Tinkerforge/red-brick/README.rst

RED Brick
=========

This repository contains hardware design files and the build system for the
software image of the RED Brick. More information about it can be found
`here <http://www.tinkerforge.com/en/doc/Hardware/Bricks/RED_Brick.html>`__.
