Tinkerforge/red-brick/image/patches/root-fs/common/usr/share/images/tf-screensaver/tf-image.png

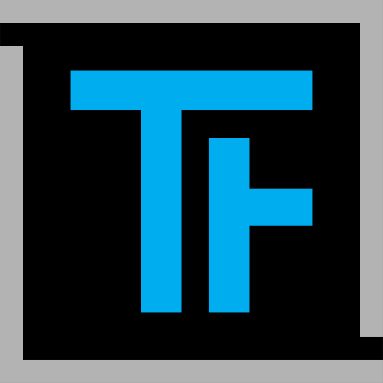
image/patches/root-fs/common/usr/share/images/tf-screensaver/tf-image.png
