Tinkerforge/red-brick/image/patches/root-fs/full/tmp/panel-buttons/tinkerforge-system-reboot.png

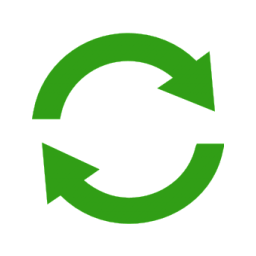
image/patches/root-fs/full/tmp/panel-buttons/tinkerforge-system-reboot.png
