Tinkerforge/red-brick/image/patches/root-fs/full/tmp/panel-buttons/tinkerforge-system-shutdown.png

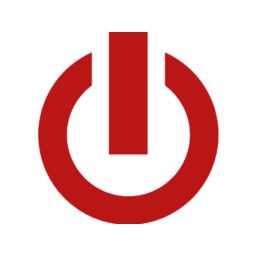
image/patches/root-fs/full/tmp/panel-buttons/tinkerforge-system-shutdown.png
