Tinkerforge/red-brick/software/examples/labview/Example Kill Program Process.vi.png

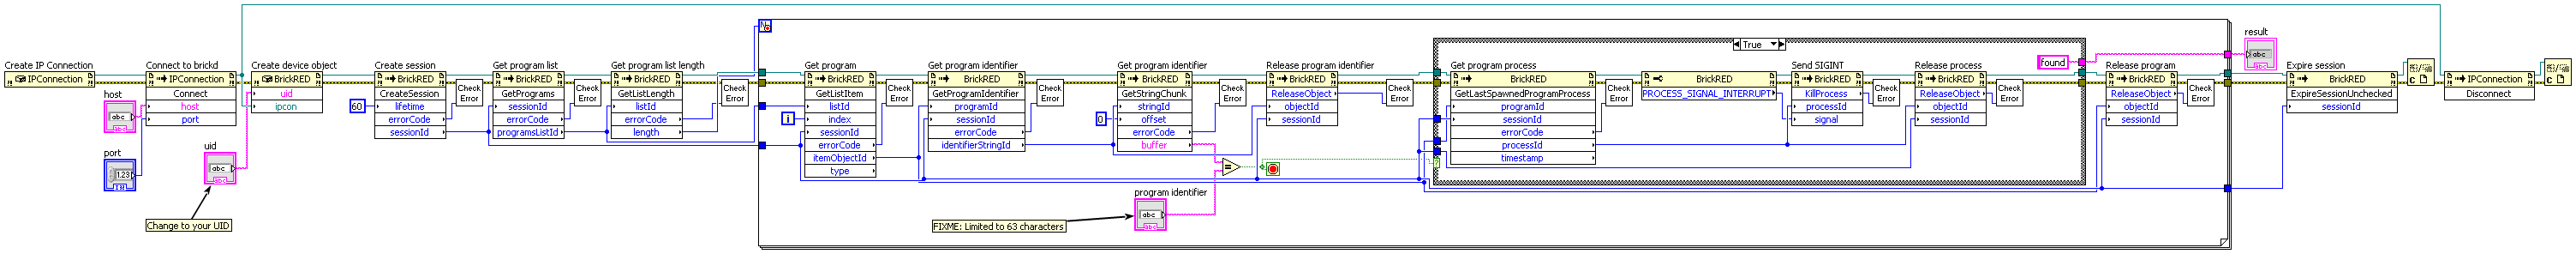
software/examples/labview/Example Kill Program Process.vi.png
