Tinkerforge/red-brick/software/examples/labview/Example Read File.vi.png

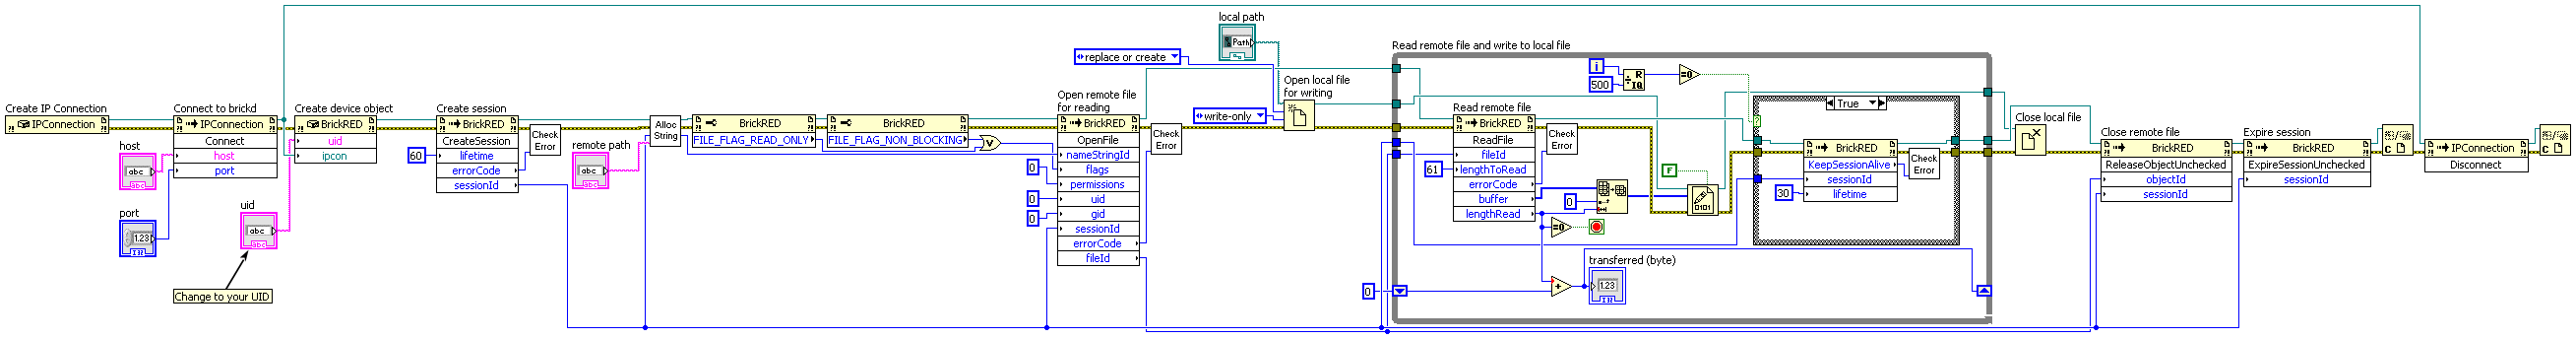
software/examples/labview/Example Read File.vi.png
