Tinkerforge/red-brick/software/examples/labview/Example Start Program.vi.png

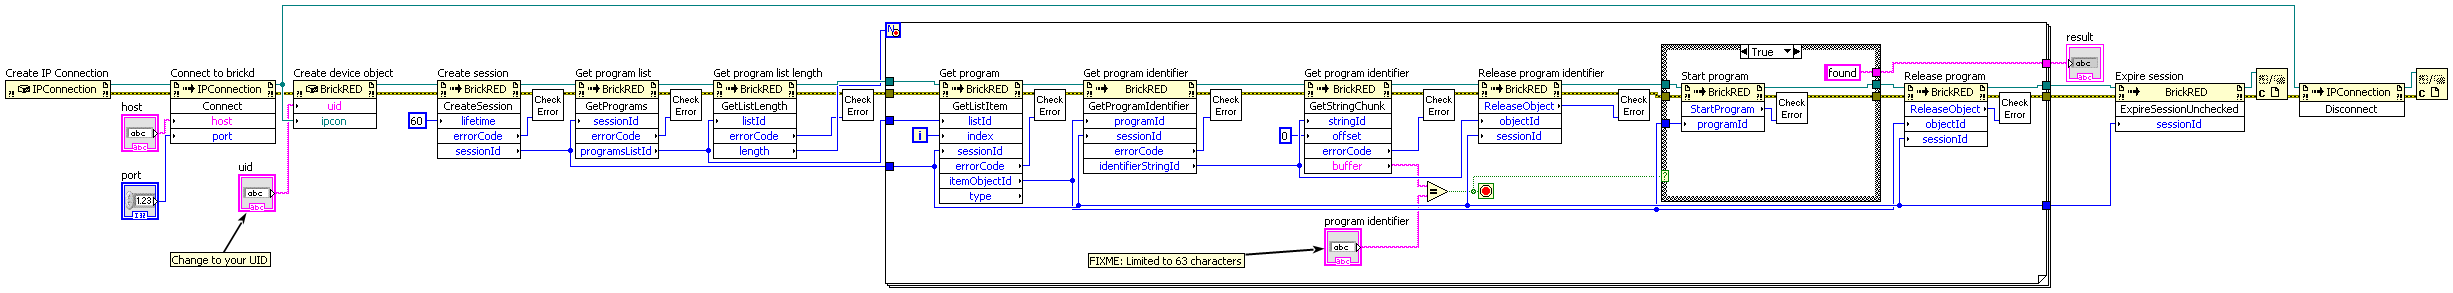
software/examples/labview/Example Start Program.vi.png
