Tinkerforge/red-brick/software/examples/labview/Example Write File.vi.png

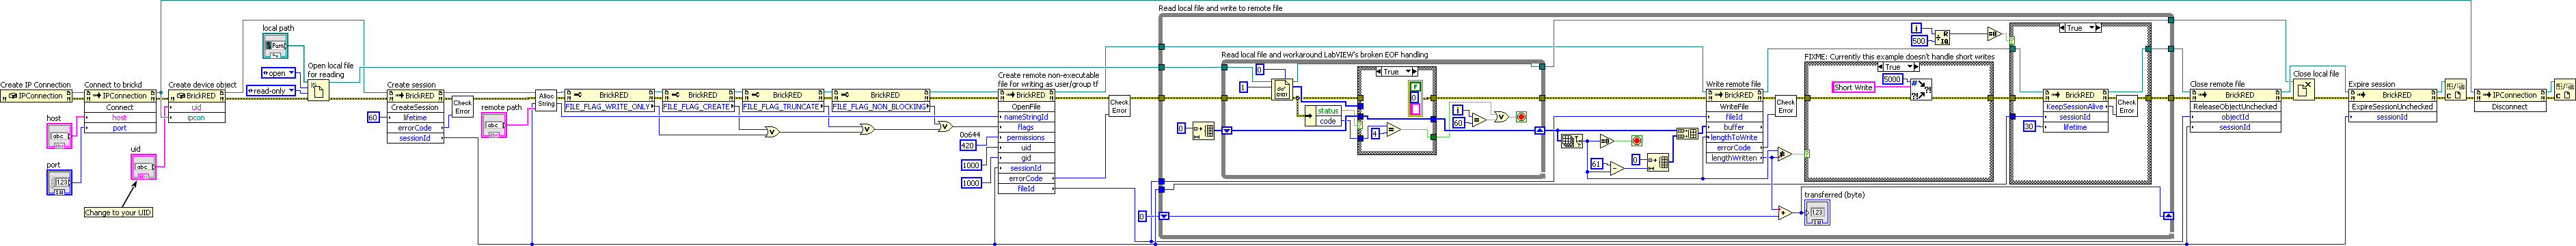
software/examples/labview/Example Write File.vi.png
