Tinkerforge/red-brick/image/patches/root-fs/common/tmp/tinkerforge_touch_calibrator/tinkerforge_touch_calibrator.png

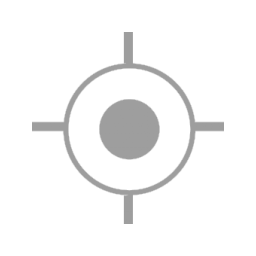
image/patches/root-fs/common/tmp/tinkerforge_touch_calibrator/tinkerforge_touch_calibrator.png
