Tinkerforge/red-brick/image/todo.txt

- compat ID detection for WinUSB with a USB composite device with more than one
  interface dosn't work on Windows XP

- acpid is complaining about not working netlink communication with the kernel.
  are we missing a kernel module for this?

- use noatime,nodiratime for file system mounting
