Tinkerforge/red-brick/(threads)

Thread 3 (2016-11-08):

Use better filesystem fo SD cards - f2fs

miroslavbucek, 2016-11-08:
https://en.wikipedia.org/wiki/F2FS

photron, 2016-11-08:
The RED Brick currently uses kernel version 3.5, but F2FS was added in kernel version 3.8. Therefore, we cannot use this filesystem on the RED Brick right now.

miroslavbucek, 2016-11-08:
thanks

photron, 2022-12-16:
Active development for the RED Brick has stopped, as the product is discontinued. Closing the issue.

Closed 2022-12-16.
