Tinkerforge/red-brick/hardware/red-schematic.pdf

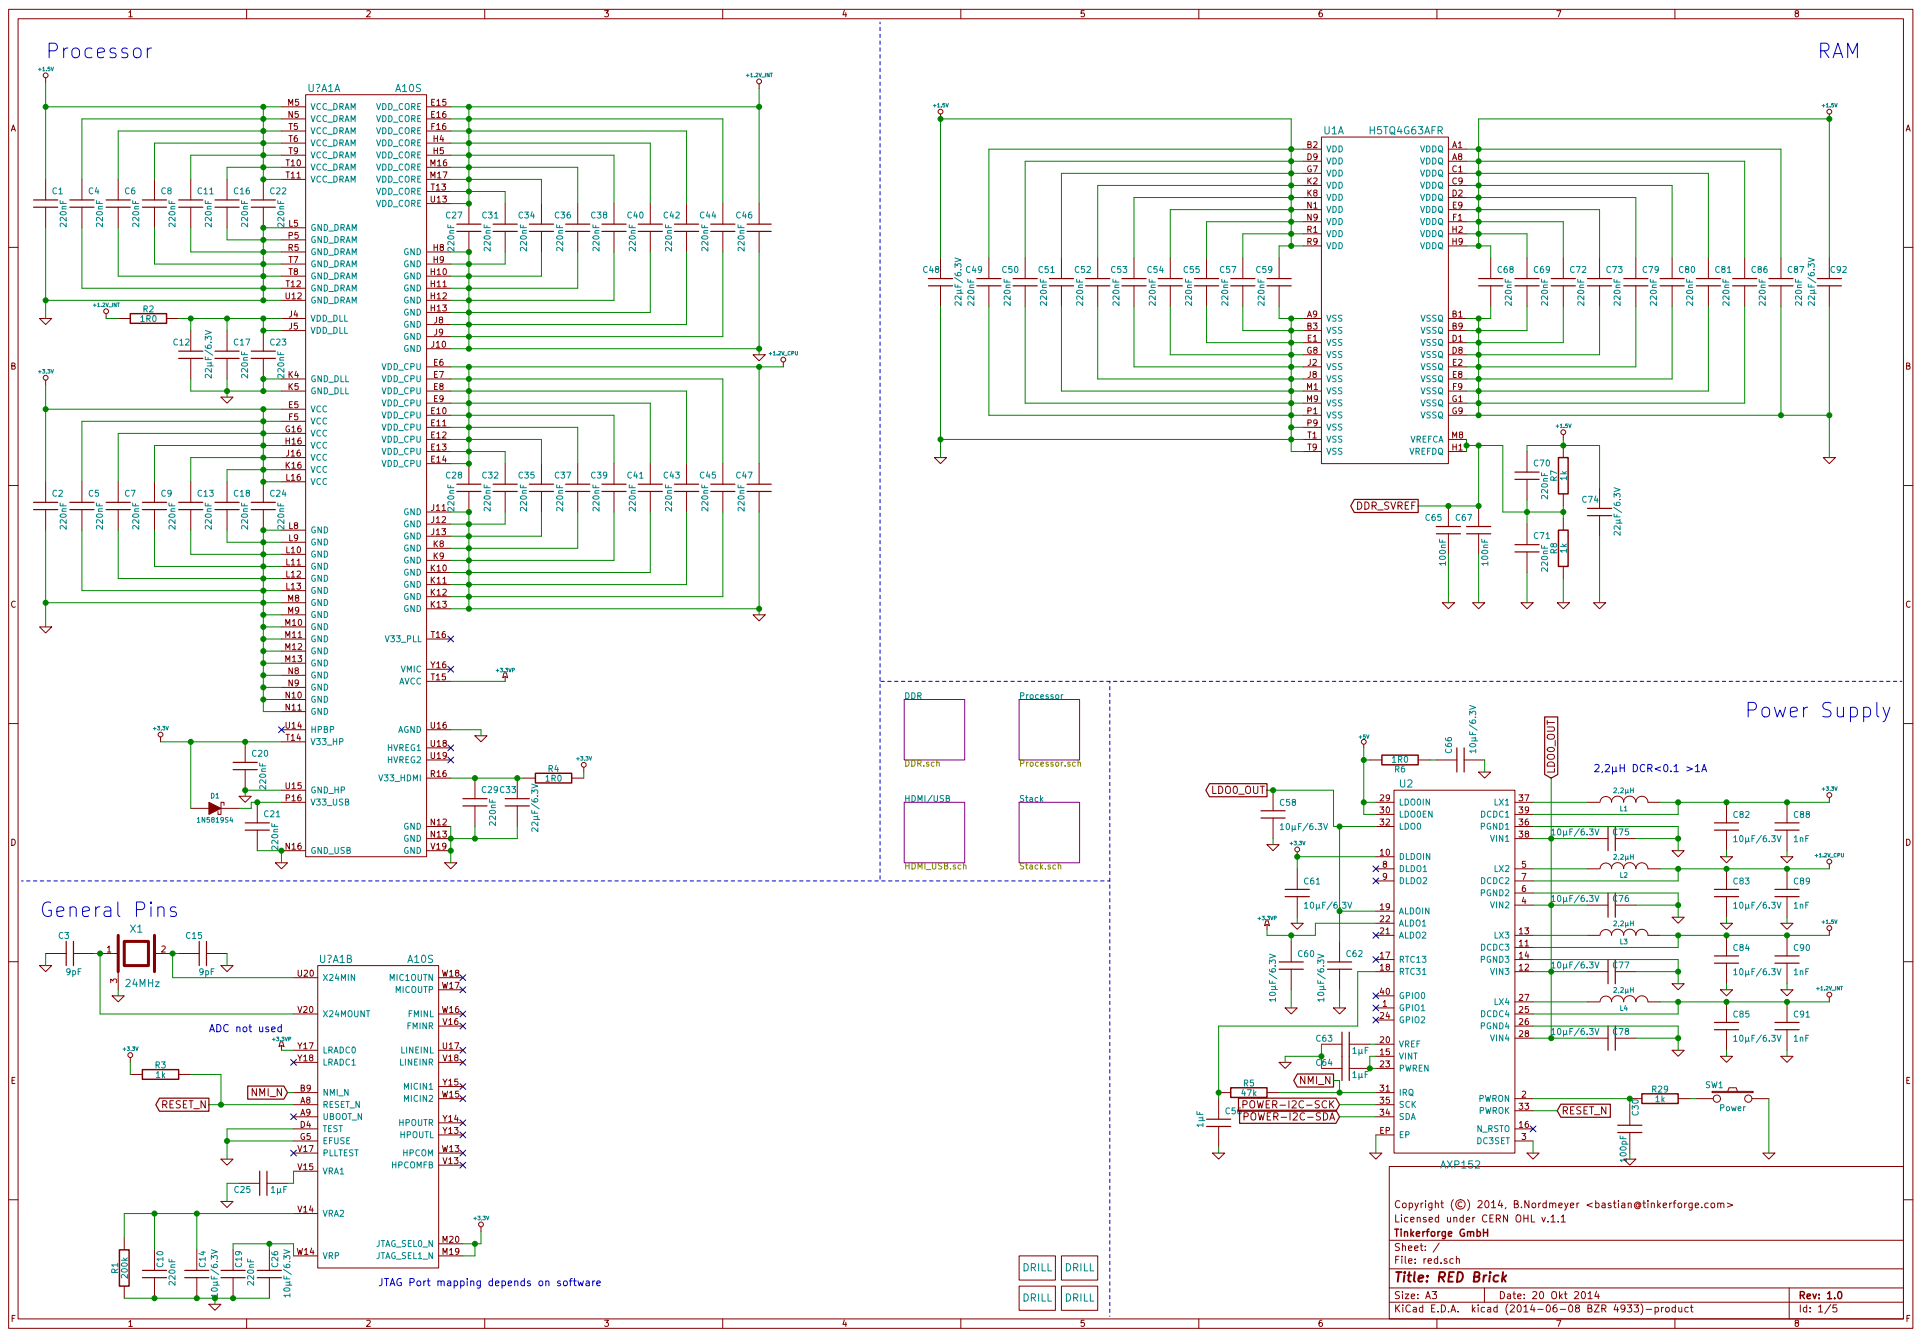
[picture p9: page 1]

Licensed under CERN OHL v.1.1 Copyright (©) 2014, B.Nordmeyer <bastian@tinkerforge.com>

File: red.sch Sheet: / Tinkerforge GmbH

Id: 1/5 Title: RED Brick

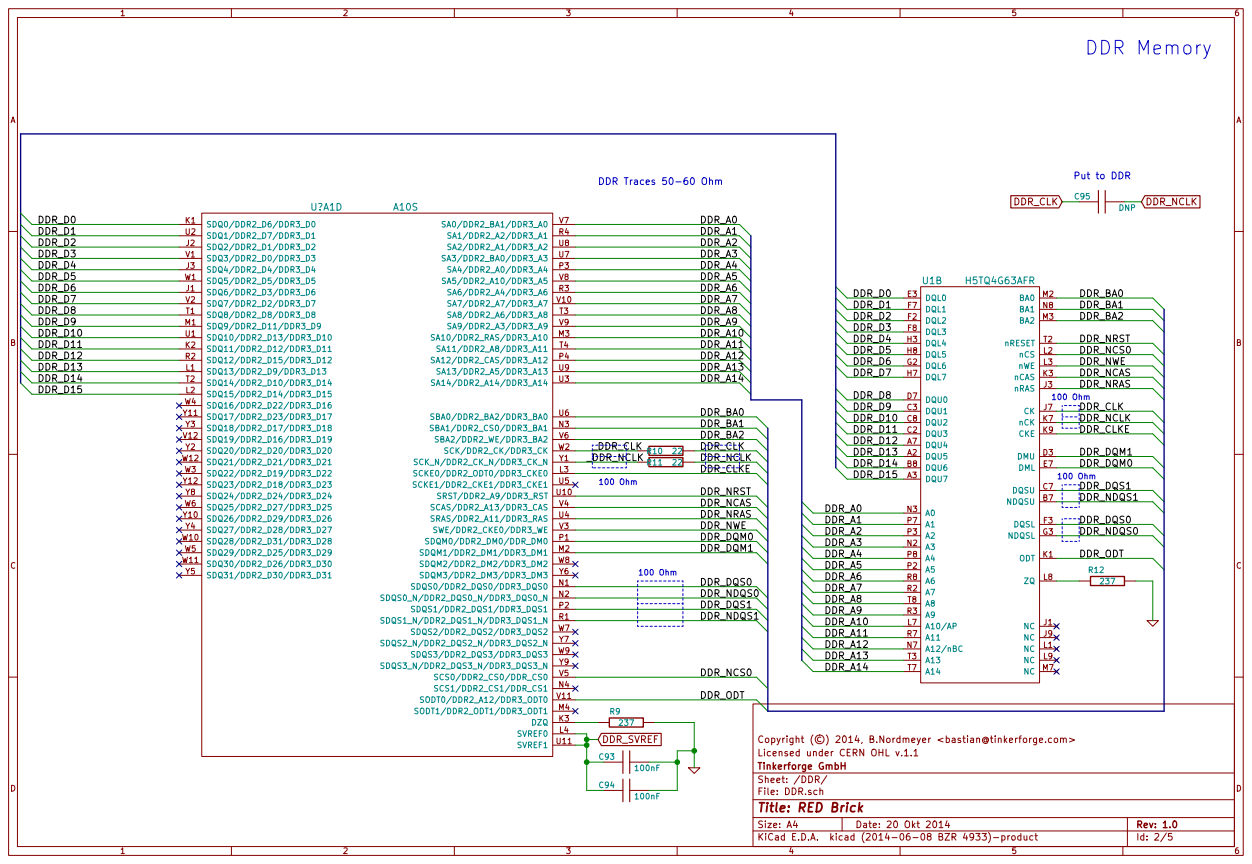
[picture p10: page 2]

DDR_NDQS0
DDR_DQS1
DDR_NDQS1

Licensed under CERN OHL v.1.1 Copyright (©) 2014, B.Nordmeyer <bastian@tinkerforge.com>

File: DDR.sch Sheet: /DDR/ Tinkerforge GmbH

Id: 2/5 Title: RED Brick

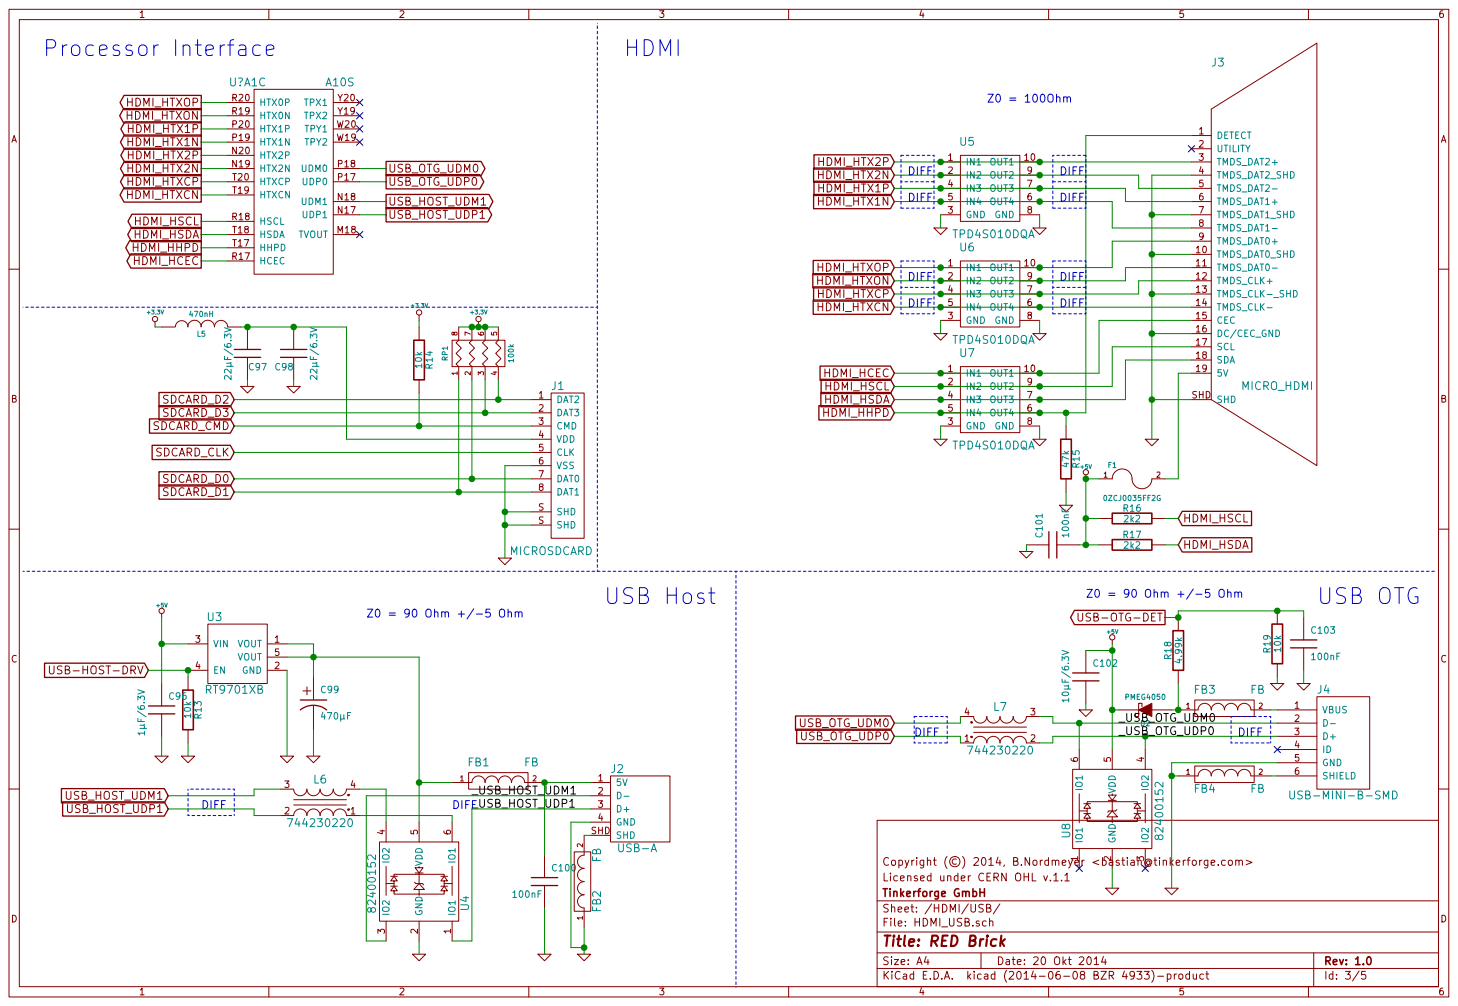
[picture p11: page 3]

Licensed under CERN OHL v.1.1 Copyright (©) 2014, B.Nordmeyer <bastian@tinkerforge.com>

File: HDMI_USB.sch Sheet: /HDMI/USB/ Tinkerforge GmbH

Id: 3/5 Title: RED Brick

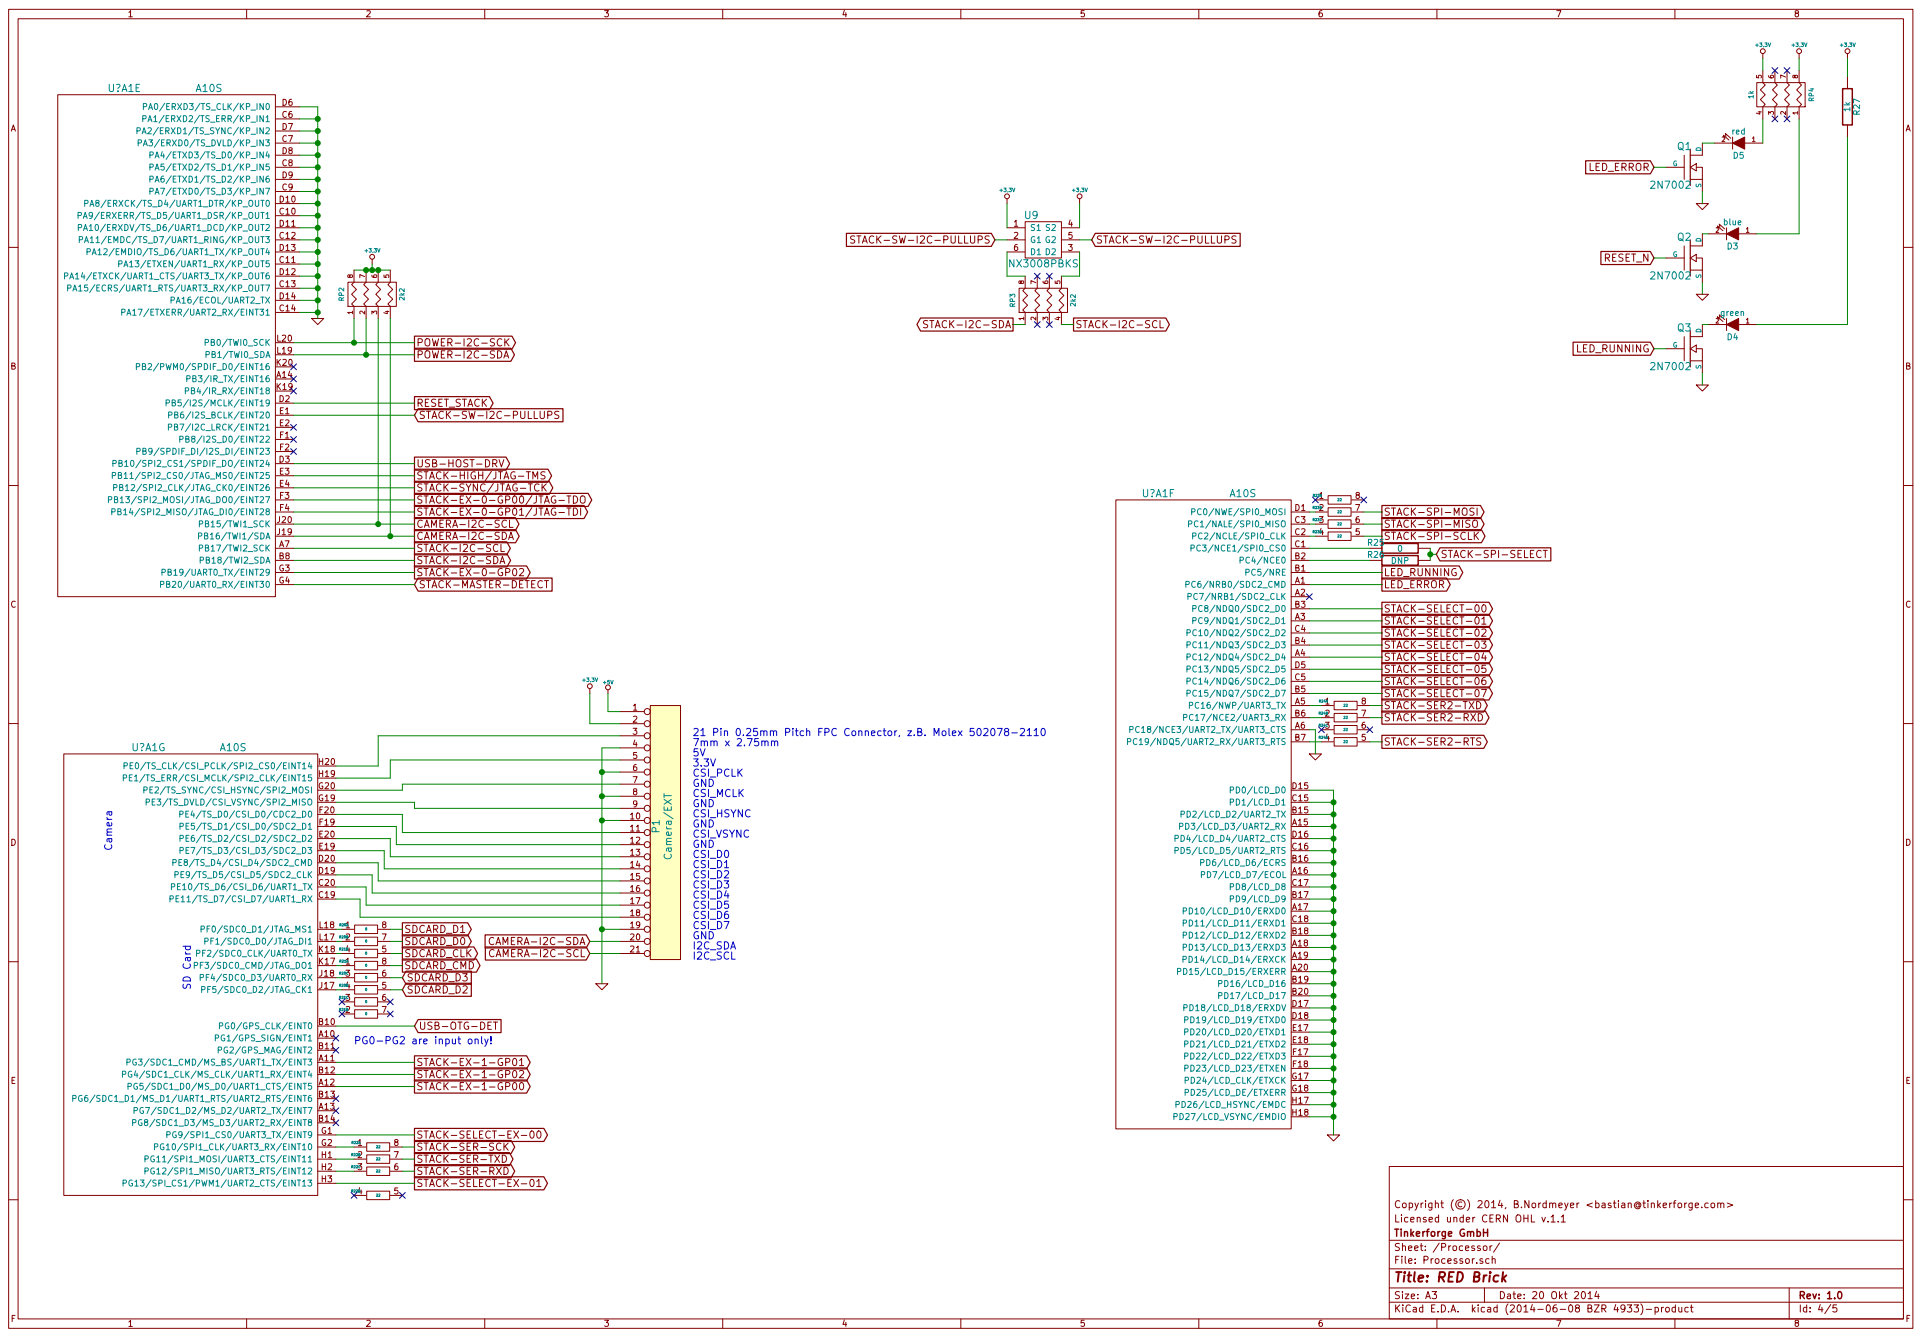
[picture p12: page 4]

5 RP3 2k2 STACK-SW-I2C-PULLUPS STACK-SW-I2C-PULLUPS

+3,3V +5V CAMERA-I2C-SDA CAMERA-I2C-SCL CAMERA-I2C-SDA CAMERA-I2C-SCL

RESET_STACK
STACK-SW-I2C-PULLUPS
STACK-EX-0-GP02 STACK-EX-1-GP00 STACK-EX-1-GP01 STACK-EX-1-GP02

STACK-SPI-SELECT USB-HOST-DRV
STACK-HIGH/JTAG-TMS
STACK-SYNC/JTAG-TCK
STACK-EX-0-GP00/JTAG-TDO
STACK-EX-0-GP01/JTAG-TDI STACK-I2C-SDA

STACK-SPI-MOSI STACK-SPI-SCLK

21 Pin 0.25mm Pitch FPC Connector, z.B. Molex 502078-2110 7mm x 2.75mm
3.3V CSI_PCLK GND

Licensed under CERN OHL v.1.1 Copyright (©) 2014, B.Nordmeyer <bastian@tinkerforge.com> Camera

13
14
15

17
18

File: Processor.sch Sheet: /Processor/ Tinkerforge GmbH

Id: 4/5 Title: RED Brick

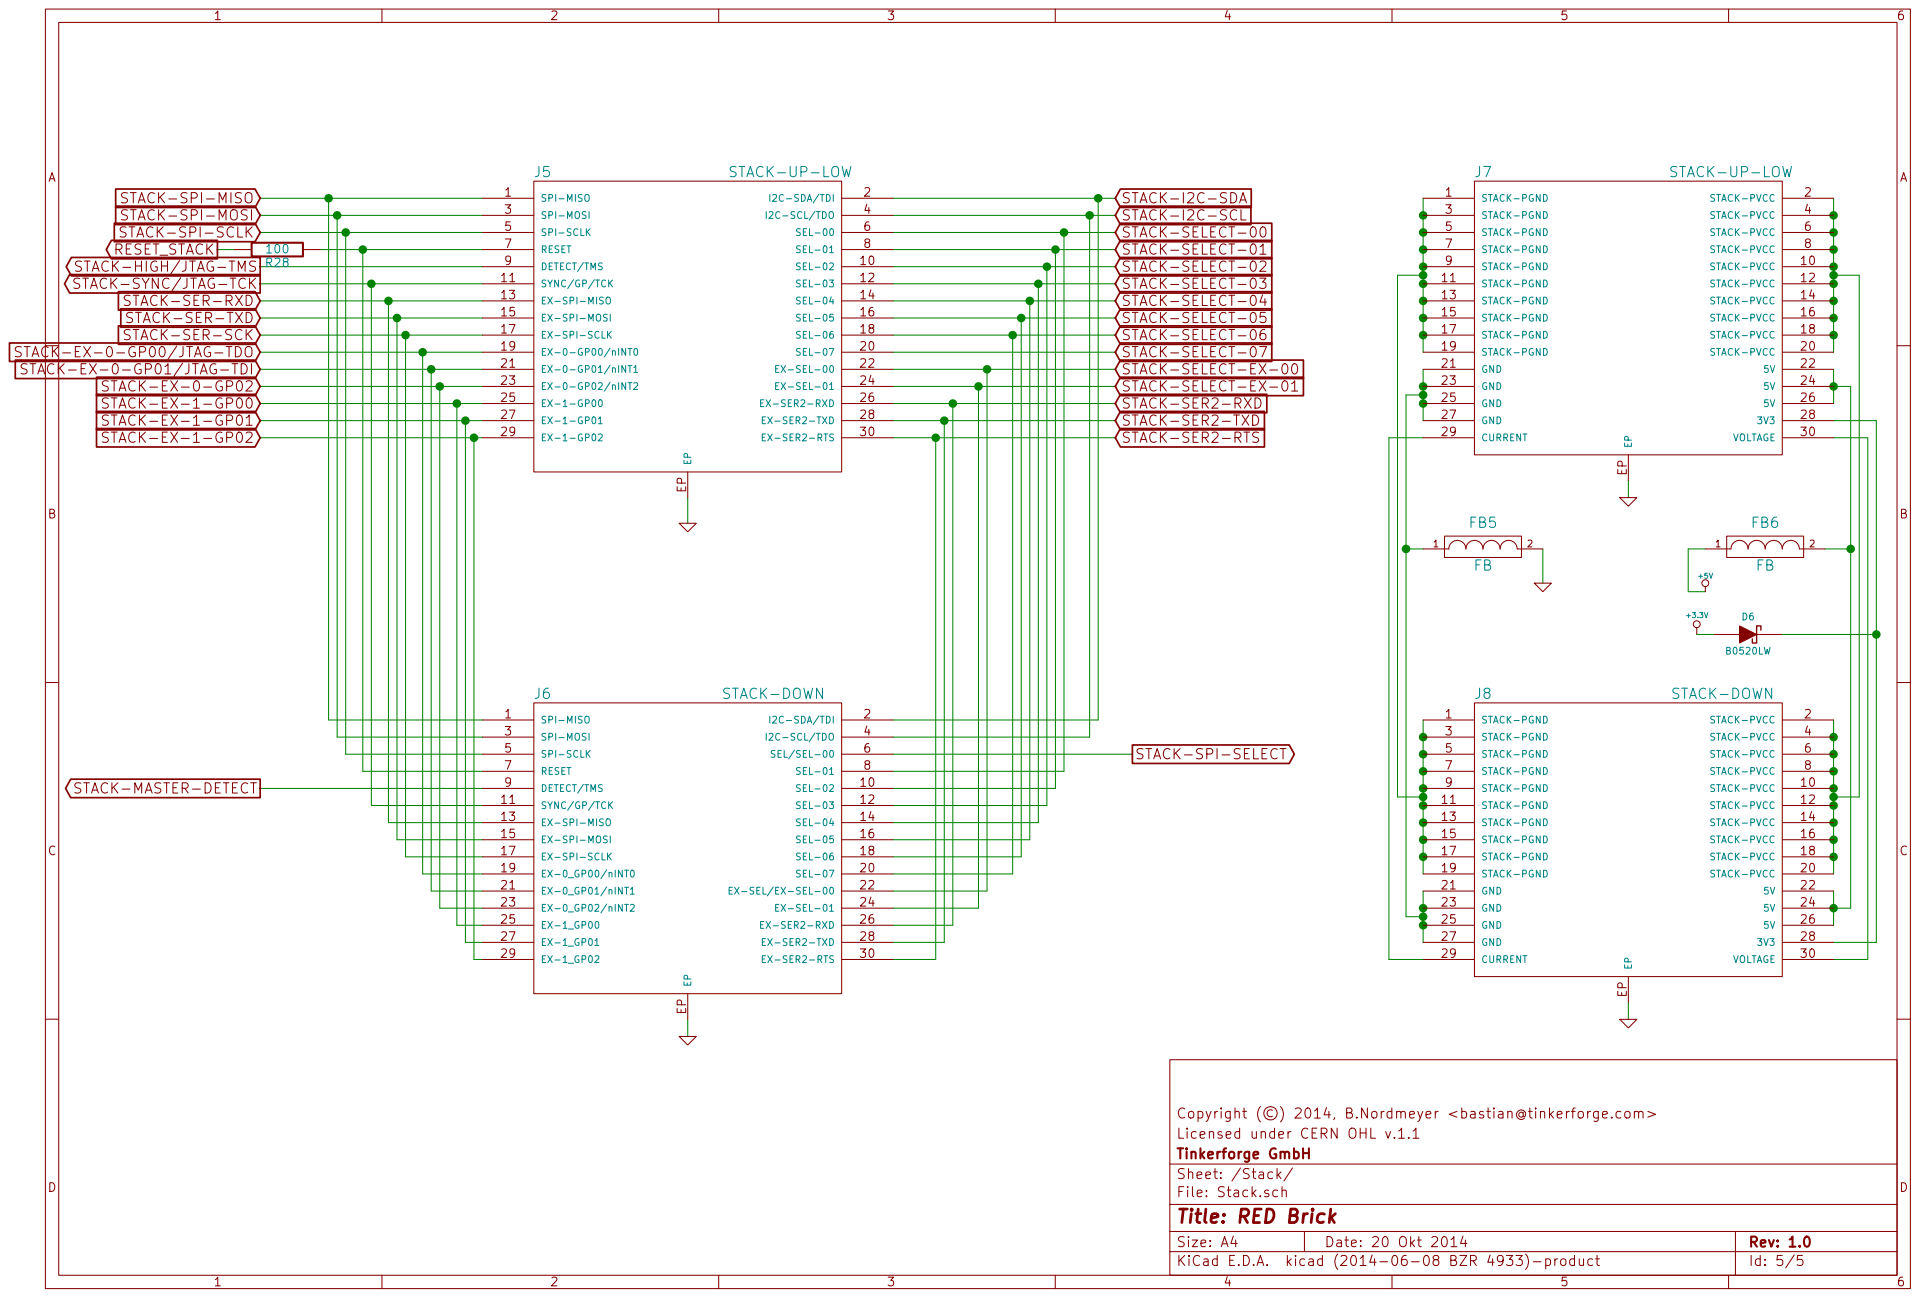
[picture p13: page 5]

STACK-SPI-MOSI
STACK-SPI-SCLK
RESET_STACK
100 STACK-EX-0-GP02
STACK-HIGH/JTAG-TMS
STACK-SYNC/JTAG-TCK
STACK-SER-RXD
STACK-SER-TXD
STACK-SER-SCK

STACK-EX-0-GP00/JTAG-TDO
STACK-EX-0-GP01/JTAG-TDI

Licensed under CERN OHL v.1.1 Copyright (©) 2014, B.Nordmeyer <bastian@tinkerforge.com>

File: Stack.sch Sheet: /Stack/ Tinkerforge GmbH

Id: 5/5 Title: RED Brick
