Tinkerforge/red-brick/hardware/red.kicad_pcb

## KiCad design hardware/red.kicad_pcb (2018-07-25)

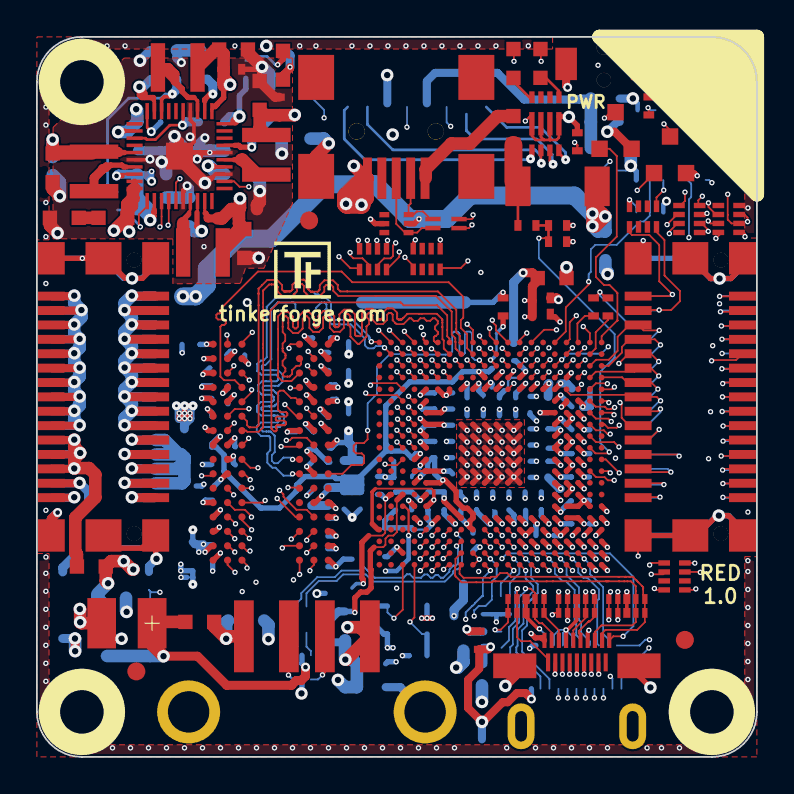
[picture p14: board red.kicad_pcb from above]

Board: 6 copper layers, 40.0 x 40.0 mm, 188 parts (0 on the bottom side), 204 nets.

Parts:
C1, C2, C4, C5, C6, C7, C8, C9, C10, C11, C13, C16, C17, C18, C19, C20, C21, C22, C23, C24, C27, C28, C29, C31, C32, C34, C35, C36, C37, C38, C39, C40, C41, C42, C43, C44, C45, C46, C47, C49, C50, C51, C52, C53, C54, C55, C57, C59, C68, C69, C70, C71, C72, C73, C79, C80, C81, C86, C87: 220nF; C0402
C3, C15: 9pF; C0402
C12, C33, C74, C92, C97, C98: 22µF/6.3V; C0603
C14, C26, C58, C60, C61, C62, C66, C75, C76, C77, C78, C82, C83, C84, C85, C102: 10µF/6.3V; C0603
C25, C56, C63, C64: 1µF; C0603
C30: 100pF; C0402
C48: 22µF/6.3V; R0603
C65, C67, C93, C94, C101, C103: 100nF; C0402
C88, C89, C90, C91: 1nF; C0402
C95: DNP; C0402
C96: 1µF/6.3V; C0603
C99: 470µF; 3528-21
C100: 100nF; C0805
D1: 1N5819S4; SOD-123
D2: PMEG4050; SOD-128
D3: blue; D0603
D4: green; D0603
D5: red; D0603
D6: B0520LW; SOD-123
F1: 0ZCJ0035FF2G; C1206
FB1, FB2, FB3, FB4, FB5, FB6: FB; C0603
Fiducial_Mark: VAL**; Fiducial_Mark
Fiducial_Mark#2, Fiducial_Mark#3, Fiducial_Mark#4, Fiducial_Mark#5, Fiducial_Mark#6: VAL**; Fiducial_Mark
J1: MICROSDCARD; MicroSD_TF001A
J2: USB-A; USB-A-SMT-8231
J3: MICRO_HDMI; MICRO-HDMI-D
J4: USB-MINI-B-SMD
J5, J7: STACK-UP-LOW; BTB08-ACS-TOP
J6, J8: STACK-DOWN; BTB08-ACS-BTM
L1, L2, L3, L4: 2,2µH; NRH3015
L5: 470nH; C0805
L6, L7: 744230220; WE-CNSW-0603
P1: Camera/EXT; 502078-2110-C
Q1, Q2, Q3: 2N7002; SOT23GDS
R1: 200k; R0402
R2, R4: 1R0; R0402
R3, R7, R8, R27, R29: 1k; R0402
R5, R15: 47k; R0402
R6: 1R0; R0603
R9, R12: 237; R0402
R10, R11: 22; R0402
R13, R14, R19: 10k; R0402
R16, R17: 2k2; R0402
R18: 4.99k; R0402
R20, R21: 0; 4X0402
R22, R23, R24: 22; 4X0402
R25: 0; R0402
R26: DNP; R0402
R28: 100; R0402
RP1: 100k; 4X0402
RP2, RP3: 2k2; 4X0402
RP4: 1k; 4X0402
SW1: Power; TACT-SWITCH
U1: H5TQ4G63AFR; FBGA96
U2: AXP152; QFN40_5X5
U3: RT9701XB; SOT23-5
U4, U8: 82400152; SOT563
U5, U6, U7: TPD4S010DQA
U9: NX3008PBKS; SOT363
U?A1: A10S; TFBGA336
VAL: CE_5mm
VAL#2: WEEE_7mm
X1: 24MHz; CRYSTAL_3225

Connections:
3V3: C2.1, C5.1, C7.1, C9.1, C13.1, C18.1, C20.1, C24.1, C61.2, C82.2, C88.2, D1.1, L1.2, L5.1, P1.2, R3.1, R4.2, R14.1, R27.1, RP1.5, RP1.6, RP1.7, RP1.8, RP2.5, RP2.6, RP2.7, RP2.8, RP4.5, RP4.8, U2.10, U2.39, U9.1, U9.4, U?A1.E5, U?A1.F5, U?A1.G16, U?A1.H16, U?A1.J16, U?A1.K16, U?A1.L16, U?A1.M19, U?A1.M20, U?A1.T14
+1.2V_CPU: C28.1, C32.1, C35.1, C37.1, C39.1, C41.1, C43.1, C45.1, C47.1, C83.2, C89.2, L2.2, U2.7, U?A1.E6, U?A1.E7, U?A1.E8, U?A1.E9, U?A1.E10, U?A1.E11, U?A1.E12, U?A1.E13, U?A1.E14
+1.2V_INT: C27.1, C31.1, C34.1, C36.1, C38.1, C40.1, C42.1, C44.1, C46.1, C85.2, C91.2, L4.2, R2.1, U2.25, U?A1.E15, U?A1.E16, U?A1.F16, U?A1.H4, U?A1.H5, U?A1.M16, U?A1.M17, U?A1.T13, U?A1.U13
+1.5V: C1.1, C4.1, C6.1, C8.1, C11.1, C16.1, C22.1, C48.1, C49.1, C50.1, C51.1, C52.1, C53.1, C54.1, C55.1, C57.1, C59.1, C68.1, C69.1, C70.1, C72.1, C73.1, C74.1, C79.1, C80.1, C81.1, C84.2, C86.1, C87.1, C90.2, C92.1, L3.2, R7.2, U1.A1, U1.A8, U1.B2, U1.C1, U1.C9, U1.D2, U1.D9, U1.E9, U1.F1, U1.G7, U1.H2, U1.H9, U1.K2, U1.K8, U1.N1, U1.N9, U1.R1, U1.R9, U2.11, U?A1.M5, U?A1.N5, U?A1.T5, U?A1.T6, U?A1.T9, U?A1.T10, U?A1.T11
+3.3VP: C60.2, U2.22, U?A1.T15, U?A1.Y17
+5V: C96.1, C101.2, C102.1, D2.2, F1.1, FB6.1, P1.1, R6.2, R16.1, R17.1, U2.29, U2.30, U3.3, U8.5
/DDR/DDR_A0: U1.N3, U?A1.V7
/DDR/DDR_A1: U1.P7, U?A1.R4
/DDR/DDR_A2: U1.P3, U?A1.U8
/DDR/DDR_A3: U1.N2, U?A1.U7
/DDR/DDR_A4: U1.P8, U?A1.P3
/DDR/DDR_A5: U1.P2, U?A1.V8
/DDR/DDR_A6: U1.R8, U?A1.R3
/DDR/DDR_A7: U1.R2, U?A1.V10
/DDR/DDR_A8: U1.T8, U?A1.T3
/DDR/DDR_A9: U1.R3, U?A1.V9
/DDR/DDR_A10: U1.L7, U?A1.M3
/DDR/DDR_A11: U1.R7, U?A1.T4
/DDR/DDR_A12: U1.N7, U?A1.P4
/DDR/DDR_A13: U1.T3, U?A1.U9
/DDR/DDR_A14: U1.T7, U?A1.U3
/DDR/DDR_BA0: U1.M2, U?A1.U6
/DDR/DDR_BA1: U1.N8, U?A1.N3
/DDR/DDR_BA2: U1.M3, U?A1.V6
/DDR/DDR_CLKE: U1.K9, U?A1.L3
/DDR/DDR_D0: U1.E3, U?A1.K1
/DDR/DDR_D1: U1.F7, U?A1.U2
/DDR/DDR_D2: U1.F2, U?A1.J2
/DDR/DDR_D3: U1.F8, U?A1.V1
/DDR/DDR_D4: U1.H3, U?A1.J3
/DDR/DDR_D5: U1.H8, U?A1.W1
/DDR/DDR_D6: U1.G2, U?A1.J1
/DDR/DDR_D7: U1.H7, U?A1.V2
/DDR/DDR_D8: U1.D7, U?A1.T1
/DDR/DDR_D9: U1.C3, U?A1.M1
/DDR/DDR_D10: U1.C8, U?A1.U1
/DDR/DDR_D11: U1.C2, U?A1.K2
/DDR/DDR_D12: U1.A7, U?A1.R2
/DDR/DDR_D13: U1.A2, U?A1.L1
/DDR/DDR_D14: U1.B8, U?A1.T2
/DDR/DDR_D15: U1.A3, U?A1.L2
/DDR/DDR_DQM0: U1.E7, U?A1.P1
/DDR/DDR_DQM1: U1.D3, U?A1.M2
/DDR/DDR_DQS0: U1.F3, U?A1.N1
/DDR/DDR_DQS1: U1.C7, U?A1.P2
/DDR/DDR_NCAS: U1.K3, U?A1.V4
/DDR/DDR_NCS0: U1.L2, U?A1.V5
/DDR/DDR_NDQS0: U1.G3, U?A1.N2
/DDR/DDR_NDQS1: U1.B7, U?A1.R1
/DDR/DDR_NRAS: U1.J3, U?A1.U4
/DDR/DDR_NRST: U1.T2, U?A1.U10
/DDR/DDR_NWE: U1.L3, U?A1.V3
/DDR/DDR_ODT: U1.K1, U?A1.V11
/DDR/_DDR_CLK: R10.1, U?A1.W2
/DDR/_DDR_NCLK: R11.1, U?A1.Y1
/HDMI/USB/_USB_HOST_UDM1: J2.2, U4.3
/HDMI/USB/_USB_HOST_UDP1: J2.3, U4.1
/HDMI/USB/_USB_OTG_UDM0: J4.2, L7.3, U8.6
/HDMI/USB/_USB_OTG_UDP0: J4.3, L7.2, U8.4
CAMERA-I2C-SCL: P1.21, RP2.3, U?A1.J20
CAMERA-I2C-SDA: P1.20, RP2.4, U?A1.J19
DDR_CLK: C95.1, R10.2, U1.J7
DDR_NCLK: C95.2, R11.2, U1.K7
DDR_SVREF: C65.1, C67.1, C70.2, C71.1, C93.1, C94.1, R7.1, R8.2, U1.H1, U1.M8, U?A1.L4, U?A1.U11
GND: C1.2, C2.2, C3.1, C4.2, C5.2, C6.2, C7.2, C8.2, C9.2, C10.2, C11.2, C12.2, C13.2, C14.2, C15.2, C16.2, C17.2, C18.2, C19.2, C20.2, C21.2, C22.2, C23.2, C24.2, C25.1, C26.2, C27.2, C28.2, C29.2, C30.1, C31.2, C32.2, C33.2, C34.2, C35.2, C36.2, C37.2, C38.2, C39.2, C40.2, C41.2, C42.2, C43.2, C44.2, C45.2, C46.2, C47.2, C48.2, C49.2, C50.2, C51.2, C52.2, C53.2, C54.2, C55.2, C56.1, C57.2, C58.1, C59.2, C60.1, C61.1, C62.1, C63.2, C64.2, C65.2, C66.1, C67.2, C68.2, C69.2, C71.2, C72.2, C73.2, C74.2, C75.2, C76.2, C77.2, C78.2, C79.2, C80.2, C81.2, C82.1, C83.1, C84.1, C85.1, C86.2, C87.2, C88.1, C89.1, C90.1, C91.1, C92.2, C93.2, C94.2, C96.2, C97.1, C98.1, C99.2, C100.2, C101.1, C102.2, C103.2, FB2.1, FB4.1, FB5.2, J1.6, J1.S, J2.4, J3.4, J3.7, J3.10, J3.13, J3.16, J3.SHD, J4.5, J5.EP, J6.EP, J7.EP, J8.EP, P1.4, P1.6, P1.8, P1.10, P1.19, Q1.S, Q2.S, Q3.S, R1.1, R8.1, R9.2, R12.2, R13.2, R15.2, R19.1, SW1.1, U1.A9, U1.B1, U1.B3, U1.B9, U1.D1, U1.D8, U1.E1, U1.E2, U1.E8, U1.F9, U1.G1, U1.G8, U1.G9, U1.J2, U1.J8, U1.M1, U1.M9, U1.P1, U1.P9, U1.T1, U1.T9, U2.3, U2.6, U2.14, U2.26, U2.36, U2.EP, U3.2, U4.2, U5.3, U5.8, U6.3, U6.8, U7.3, U7.8, U8.2, U?A1.A6, U?A1.A15, U?A1.A16, U?A1.A17, U?A1.A18, U?A1.A19, U?A1.A20, U?A1.B15, U?A1.B16, U?A1.B17, U?A1.B18, U?A1.B19, U?A1.B20, U?A1.C6, U?A1.C7, U?A1.C8, U?A1.C9, U?A1.C10, U?A1.C11, U?A1.C12, U?A1.C13, U?A1.C14, U?A1.C15, U?A1.C16, U?A1.C17, U?A1.C18, U?A1.D4, U?A1.D6, U?A1.D7, U?A1.D8, U?A1.D9, U?A1.D10, U?A1.D11, U?A1.D12, U?A1.D13, U?A1.D14, U?A1.D15, U?A1.D16, U?A1.D17, U?A1.D18, U?A1.E17, U?A1.E18, U?A1.F17, U?A1.F18, U?A1.G5, U?A1.G17, U?A1.G18, U?A1.H8, U?A1.H9, U?A1.H10, U?A1.H11, U?A1.H12, U?A1.H13, U?A1.H17, U?A1.H18, U?A1.J8, U?A1.J9, U?A1.J10, U?A1.J11, U?A1.J12, U?A1.J13, U?A1.K4, U?A1.K5, U?A1.K8, U?A1.K9, U?A1.K10, U?A1.K11, U?A1.K12, U?A1.K13, U?A1.L5, U?A1.L8, U?A1.L9, U?A1.L10, U?A1.L11, U?A1.L12, U?A1.L13, U?A1.M8, U?A1.M9, U?A1.M10, U?A1.M11, U?A1.M12, U?A1.M13, U?A1.N8, U?A1.N9, U?A1.N10, U?A1.N11, U?A1.N12, U?A1.N13, U?A1.N16, U?A1.P5, U?A1.R5, U?A1.T7, U?A1.T8, U?A1.T12, U?A1.U12, U?A1.U15, U?A1.U16, U?A1.V19, X1.3
HDMI_HCEC: J3.15, U7.1, U7.10, U?A1.R17
HDMI_HHPD: J3.1, R15.1, U7.5, U7.6, U?A1.T17
HDMI_HSCL: J3.17, R16.2, U7.2, U7.9, U?A1.R18
HDMI_HSDA: J3.18, R17.2, U7.4, U7.7, U?A1.T18
HDMI_HTX1N: J3.8, U5.5, U5.6, U?A1.P19
HDMI_HTX1P: J3.6, U5.4, U5.7, U?A1.P20
HDMI_HTX2N: J3.5, U5.2, U5.9, U?A1.N19
HDMI_HTX2P: J3.3, U5.1, U5.10, U?A1.N20
HDMI_HTXCN: J3.14, U6.5, U6.6, U?A1.T19
HDMI_HTXCP: J3.12, U6.4, U6.7, U?A1.T20
HDMI_HTXON: J3.11, U6.2, U6.9, U?A1.R19
HDMI_HTXOP: J3.9, U6.1, U6.10, U?A1.R20
LDO0_OUT: C58.2, C62.2, C75.1, C76.1, C77.1, C78.1, U2.4, U2.12, U2.19, U2.28, U2.32, U2.38
LED_ERROR: Q1.G, U?A1.A1
LED_RUNNING: Q3.G, U?A1.B1
NMI_N: R5.2, U2.31, U?A1.B9
unnamed: C3.2, U?A1.V20, X1.1
unnamed: C10.1, C14.1, R1.2, U?A1.V14
unnamed: C12.1, C17.1, C23.1, R2.2, U?A1.J4, U?A1.J5
unnamed: C15.1, U?A1.U20, X1.2
unnamed: C19.1, C26.1, U?A1.W14
unnamed: C21.1, D1.2, U?A1.P16
unnamed: C25.2, U?A1.V15
unnamed: C29.1, C33.1, R4.1, U?A1.R16
unnamed: C30.2, R29.1, U2.2
unnamed: C56.2, R5.1, U2.18
unnamed: C63.1, U2.20
unnamed: C64.1, U2.15, U2.23
unnamed: C66.2, R6.1
unnamed: C97.2, C98.2, J1.4, L5.2
unnamed: C99.1, FB1.1, U3.1, U3.5, U4.5
unnamed: C100.1, FB1.2, J2.1
unnamed: D2.1, FB3.1, R18.1
unnamed: D3.1, RP4.1
unnamed: D3.2, Q2.D
unnamed: D4.1, R27.2
unnamed: D4.2, Q3.D
unnamed: D5.1, RP4.4
unnamed: D5.2, Q1.D
unnamed: D6.2, J7.28, J8.28
unnamed: F1.2, J3.19
unnamed: FB2.2, J2.SHD
unnamed: FB3.2, J4.1
unnamed: FB4.2, J4.6
unnamed: FB5.1, J7.21, J7.23, J7.25, J7.27, J8.21, J8.23, J8.25, J8.27
unnamed: FB6.2, J7.22, J7.24, J7.26, J8.22, J8.24, J8.26
unnamed: J5.7, J6.7, R28.1
unnamed: J7.1, J7.3, J7.5, J7.7, J7.9, J7.11, J7.13, J7.15, J7.17, J7.19, J8.1, J8.3, J8.5, J8.7, J8.9, J8.11, J8.13, J8.15, J8.17, J8.19
unnamed: J7.2, J7.4, J7.6, J7.8, J7.10, J7.12, J7.14, J7.16, J7.18, J7.20, J8.2, J8.4, J8.6, J8.8, J8.10, J8.12, J8.14, J8.16, J8.18, J8.20
unnamed: J7.29, J8.29
unnamed: J7.30, J8.30
unnamed: L1.1, U2.37
unnamed: L2.1, U2.5
unnamed: L3.1, U2.13
unnamed: L4.1, U2.27
unnamed: L6.1, U4.6
unnamed: L6.4, U4.4
unnamed: P1.3, U?A1.H20
unnamed: P1.5, U?A1.H19
unnamed: P1.7, U?A1.G20
unnamed: P1.9, U?A1.G19
unnamed: P1.11, U?A1.F20
unnamed: P1.12, U?A1.F19
unnamed: P1.13, U?A1.E20
unnamed: P1.14, U?A1.E19
unnamed: P1.15, U?A1.D20
unnamed: P1.16, U?A1.D19
unnamed: P1.17, U?A1.C20
unnamed: P1.18, U?A1.C19
unnamed: R9.1, U?A1.K3
unnamed: R12.1, U1.L8
unnamed: R20.1, U?A1.L18
unnamed: R20.2, U?A1.L17
unnamed: R20.3, U?A1.J18
unnamed: R20.4, U?A1.J17
unnamed: R21.1, U?A1.K17
unnamed: R21.4, U?A1.K18
unnamed: R22.1, U?A1.G2
unnamed: R22.2, U?A1.H1
unnamed: R22.3, U?A1.H2
unnamed: R23.2, U?A1.D1
unnamed: R23.3, U?A1.C3
unnamed: R23.4, U?A1.C2
unnamed: R24.1, U?A1.A5
unnamed: R24.2, U?A1.B6
unnamed: R24.4, U?A1.B7
unnamed: R25.1, U?A1.C1
unnamed: R26.1, U?A1.B2
unnamed: R29.2, SW1.2
unnamed: RP3.5, U9.3
unnamed: RP3.8, U9.6
POWER-I2C-SCK: RP2.1, U2.35, U?A1.L20
POWER-I2C-SDA: RP2.2, U2.34, U?A1.L19
RESET_N: Q2.G, R3.2, U2.33, U?A1.A8
RESET_STACK: R28.2, U?A1.D2
SDCARD_CLK: J1.5, R21.5
SDCARD_CMD: J1.3, R14.2, R21.8
SDCARD_D0: J1.7, R20.7, RP1.2
SDCARD_D1: J1.8, R20.8, RP1.1
SDCARD_D2: J1.1, R20.5, RP1.4
SDCARD_D3: J1.2, R20.6, RP1.3
STACK-EX-0-GP00/JTAG-TDO: J5.19, J6.19, U?A1.F3
STACK-EX-0-GP01/JTAG-TDI: J5.21, J6.21, U?A1.F4
STACK-EX-0-GP02: J5.23, J6.23, U?A1.G3
STACK-EX-1-GP00: J5.25, J6.25, U?A1.A12
STACK-EX-1-GP01: J5.27, J6.27, U?A1.A11
STACK-EX-1-GP02: J5.29, J6.29, U?A1.B12
STACK-HIGH/JTAG-TMS: J5.9, U?A1.E3
STACK-I2C-SCL: J5.4, J6.4, RP3.4, U?A1.A7
STACK-I2C-SDA: J5.2, J6.2, RP3.1, U?A1.B8
STACK-MASTER-DETECT: J6.9, U?A1.G4
STACK-SELECT-00: J5.6, J6.8, U?A1.B3
STACK-SELECT-01: J5.8, J6.10, U?A1.A3
STACK-SELECT-02: J5.10, J6.12, U?A1.C4
STACK-SELECT-03: J5.12, J6.14, U?A1.B4
STACK-SELECT-04: J5.14, J6.16, U?A1.A4
STACK-SELECT-05: J5.16, J6.18, U?A1.D5
STACK-SELECT-06: J5.18, J6.20, U?A1.C5
STACK-SELECT-07: J5.20, U?A1.B5
STACK-SELECT-EX-00: J5.22, J6.22, U?A1.G1
STACK-SELECT-EX-01: J5.24, J6.24, U?A1.H3
STACK-SER2-RTS: J5.30, J6.30, R24.5
STACK-SER2-RXD: J5.26, J6.26, R24.7
STACK-SER2-TXD: J5.28, J6.28, R24.8
STACK-SER-RXD: J5.13, J6.13, R22.6
STACK-SER-SCK: J5.17, J6.17, R22.8
STACK-SER-TXD: J5.15, J6.15, R22.7
STACK-SPI-MISO: J5.1, J6.1, R23.6
STACK-SPI-MOSI: J5.3, J6.3, R23.7
STACK-SPI-SCLK: J5.5, J6.5, R23.5
STACK-SPI-SELECT: J6.6, R25.2, R26.2
STACK-SW-I2C-PULLUPS: U9.2, U9.5, U?A1.E1
STACK-SYNC/JTAG-TCK: J5.11, J6.11, U?A1.E4
USB-HOST-DRV: R13.1, U3.4, U?A1.D3
USB-OTG-DET: C103.1, R18.2, R19.2, U?A1.B10
USB_HOST_UDM1: L6.3, U?A1.N18
USB_HOST_UDP1: L6.2, U?A1.N17
USB_OTG_UDM0: L7.4, U?A1.P18
USB_OTG_UDP0: L7.1, U?A1.P17
