Tinkerforge/red-brick/(commit log)

2014-02-27 add design files for red brick prototype
    [DDR.sch, HDMI_USB.sch, Processor.sch, Stack.sch, red.kicad_pcb, red.sch]
2014-02-27 schematic for red brick prototype in pdf format
2014-02-27 ordered hardware version changed assignment of resistor networks for sdcard signals
    [DDR.sch, HDMI_USB.sch, Processor.sch, Stack.sch, red.kicad_pcb, red.sch]
2014-04-28 red-brick-image: 1. changed browser to midori 2. added php-pear 3. added Perl modules libthread-queue-perl(Thread::Queue) and libdigest-hmac-perl(Digest::HMAC) 4. re-arranged Raspbian stanza
2014-05-02 red-brick-image: fix on Perl Thread::Queue upgrade code
2014-05-02 red-brick-image: fixed case type
2014-05-04 red-brick-image: added mount directory option for copying rootfs files to the image
2014-05-06 image: Avoid fully re-cloning huge git repositories
    Instead clone them once with --depth 1 and then reset and clean them
    und subsequent runs.
2014-05-07 Remove second copy of schematic
2014-05-07 image: 1. Adding memory information tool 2. Removing unused Node.JS build code 3. Adding new user rbuser 4. CPAN and Thread::Queue upgrade 5. Disabling exit on error temporarily during image partitio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
2014-05-07 image: Better way to get the executing current user's ID
2014-05-08 add current hardware version
    [DDR.sch, HDMI_USB.sch, Processor.sch, Stack.sch, red.kicad_pcb, red.sch]
2014-05-08 image: Only git pull the current branch
2014-05-10 image: Modifying cp command switches to add -a
2014-05-10 image: Stray /proc mount management on root-fs
2014-05-10 image: Removed rm verbose switch and replace cp with rsync for root-fs patching
2014-05-10 image: 1. Patching root-fs sequence fix 2. Image specific task condition check fix 3. Switch from rsync to cp for the final copying of the rootfs
2014-05-12 image: Adding uart3.patch
2014-05-12 image: Use UART3 as primary serial console
2014-05-12 image: Fixing kernel side UART3 changed
2014-05-14 image: Don't copy kernel modules to the prepared root-fs, but copy them directly to the mounted image
    This is one step towards splitting the root-fs generation and the image generation into two scripts.
2014-05-15 image: Switch to our forks for the sunxi git repos
2014-05-16 image: Supressing prompts during rootfs configuration stage
2014-05-16 image: Updating FEX file with the configuration for RED-Brick's running and error LEDs
2014-05-16 image: Add a note about problems with nodev and noexec mount options
2014-05-16 image: Adding running led management script to the image
2014-05-16 image: Fixing running LED management init script as status LED issue is fixed in U-Boot SPL code
2014-05-19 image: Change the init script name that controls the running LED. Priority is by default is set to 1 by insserv.
2014-05-19 image: Fixing running-led init script name
2014-05-22 image: Enable RED Brick USB gadget driver
2014-05-23 image: Disabling resistive touch panel and SoC audio hardware
2014-05-23 image: Enable red_brick_uid driver module
2014-05-26 image: Check before mounting for root-fs copy to the image
2014-05-26 image: Removing unused commented code line and fixing rsync switches
2014-05-26 image: Fixing cp root-fs switches
2014-05-30 image: Fix /etc/apt/sources.list in the image in case apt-cacher was used
2014-05-31 image: Fixing status LED control init script
2014-06-05 image: Changing dpkg configure sequence once with and once without /proc mounted and disabling Mono additional features setup
2014-06-10 Fix spi mux configuration
2014-06-12 image: Add acpid for proper future power button functionality
2014-06-15 image: 1. Fixed locale 2. Node.JS extra features setup doesn't work in chroot environment 3. Use host systems /etc/resolv.conf and at the end of the process simply delete it 4. Proper mount and unmou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
2014-06-23 Enable arm arch and high res timers, enable DDMA
2014-06-24 image: 1. Check for boot script file for current configuration 2. Listing file cleanup
2014-06-27 Add configuration for SPI stack communication with other Bricks
2014-06-27 Add missing SPI configuration in fast image
2014-07-02 image: 1. Fixed kernel header merge paths 2. Mono features updated 3. Two stage initial dpkg --configure -a. Once with and once without /proc mounted
2014-07-04 image: Adding SPI changes to the fast kernel config from full kernel config
2014-07-06 image: 1. Disabling kernel boot output 2. Setup rts pin of uart3 for modbus 3. Setup GPIO for selecting EEPROM for reading rs485 config over i2c 4. Added libi2c-dev, i2c-tools 5. make-image.sh checks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
2014-07-07 image: Adding GPIO for I2C pullup
2014-07-11 image: Set stack select pins high by default in FEX file
    Also add initialization for pins 11 and 12.
    Remvoe unused uart_rts.
2014-07-11 image: 1. Adding GPIOs for modbus TXE and RXE 2. By default system's UART3 is not being used for console since it will be used for modbus interface. Also debug on this interface is disabled by default
2014-07-30 image: Don't constanly remount /proc
    Just mount it once and keep it mounted through out the whole process.
    Also mount /dev/pts as suggested by the Debian chroot guide:
    https://wiki.debian.org/chroot
2014-08-07 image: Let the kernel have 4 pin UART config for UART-3 so it can control the RTS pin
2014-08-12 image: Fixed mount directory reset logic in cleanup function
2014-08-14 image: Force enabled unmount and mount directory cleanup removed from the clean up function
2014-09-01 * reset button is now used as power button * change reset circuitry: * stack reset is now connected to interrupt capable GPIO * RESET_N signal is now used only for internal reset circuitry * fix USB 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
    [DDR.sch, HDMI_USB.sch, Processor.sch, Stack.sch, red.kicad_pcb, red.sch]
2014-09-01 add powersupply datasheet
2014-09-01 change wrong component silkscreen outlines
    [HDMI_USB.sch, red.kicad_pcb]
2014-09-02 Use proper linux LED driver for green and red led
2014-09-02 Remove "running-led" script, is now done with linux kernel module
2014-09-02 Add LED configuration to fast image
2014-09-03 Add stack reset pin (input by default)
2014-09-10 fix pin names
2014-09-11 remove inverter for rts
    [Processor.sch, red.kicad_pcb]
2014-09-12 image: Removing code for setting up previously used initd based status LED.
2014-09-12 image: Adding kernel LED config for the fast kernel config which was missing.
2014-09-15 have run checks, therefore data has changed. orderable version?
    [DDR.sch, HDMI_USB.sch, Processor.sch, Stack.sch, red.kicad_pcb, red.sch]
2014-09-26 Configure GPIO interrupts correctly
2014-10-18 image: Adding support for additional WLAN drivers
2014-10-19 image: Predefined wicd config only specifies default wireless and wired interfaces
2014-10-20 fix GPIO G2 input bug
    [DDR.sch, HDMI_USB.sch, Processor.sch, Stack.sch, red.kicad_pcb, red.sch]
2014-10-21 image: AWK like tool with python support. Will be used for parsing wireless scan results
2014-10-23 Fix java configuration for current packages
2014-10-24 image: Adding iw for wireless tools
2014-10-28 image: Disable non-working RTL8192CU driver and use RTL8192CU_SW instead
2014-10-29 remove "de" from locale language setting
2014-11-03 Add Tinkerforge Bindings to default fpc configuration
    [fpc-2.6.0.cfg]
2014-11-04 Patch and compile qemu, so we can install mono-complete during bootstrap
    * The patch hacks in signal handling to add support
    for the currently unsuported sigpwr signal
2014-11-06 image: Ensure that even after installaltion of all the packages the desired patched fpc config file is used
    [fpc-2.6.0.cfg]
2014-11-12 Update reset pin to current version
2014-11-19 image: Install Delphi bindings using Makefile.fpc
    This allows to use the default fpc.cfg.
    [fpc-2.6.0.cfg]
2014-12-07 image: Removing wicd-cli patches. We don't need them anymore since now the wireless scan is done with Dbus.
2014-12-17 Fix pin of GP0 of EX0
2014-12-22 Fix pin for gpio0 of ex1
2015-01-23 image: Don't trap on exit but manually call cleanup in this case
    This allows to ensure that the "Process finished" line is always
    printed last.
2015-01-23 image: Enable FTDI and USB ethernet and mass storage gadget kernel drivers
2015-01-24 image: Adding tinkerforge touch calibrator
2015-01-24 image: Fix paths for installing tinkerforge touch calibrator
2015-01-26 image: Recompile X11 fbturbo driver for X11 ABI version 18
    Add libump packages for fbturbo driver.
    Also add proper Debian changelog to libsunxi-mali-x11 and increase
    package version.
2015-01-27 image: Disable framebuffer console blanking
2015-01-28 Use systemctl, use new images for logo and calibrator
2015-01-28 Make calibrator name shorter (so it fits in two lines)
2015-01-29 Revert "image: Use Debian provided hostapd and wpasupplicant" This reverts commit 94515ecc439a7b92f9ec2bbead0345e2012270d4.
    image: Reverting back to compiling Realtek provided hostapd and wpasupplicant.
    The driver 8188EU doesn't seem to depend on cfg80211 or mac80211 which is the linux
    way for communicating with wireless hardware. So repo provided hostapd doesn't work.
2015-01-29 image: Touch calibrator doesn't require root access anymore
2015-02-04 iMake sure w5x00 driver is available where brickd searches for it
2015-02-07 image: Removing symbolic link hack so that brickd would find ethernet extension driver.
    This is fixed in brickd by making it check for drivers based on a path constructed
    by getting kernel version using uname.
2015-03-10 image: Add default openHAB config
    [openhab.cfg]
2015-03-10 image: Remove libi2c-dev because it conflicts with linux-libc-dev
    libi2c-dev just provides /usr/include/linux/i2c-dev.h which is also
    provided by linux-libc-dev. But libi2c-dev is not marked as confliting
    with linux-libc-dev.
    Also /usr/include/linux/i2c-dev.h is already provided by our hacky way
    of including our specific version of the kernel headers.
2015-03-31 image: Rebuild libsunxi-mali-x11 to remove conflict with libegl1-mesa-drivers
    libegl1-mesa-drivers is installed indirectly by qt5-default. This will
    remove libsunxi-mali-x11 and xserver-xorg-video-sunximali. This in the
    end results in the X server being unable to find the fbturbo driver.
2015-04-21 image: Enable many more kernel drivers for USB devices
    For example, serial adapters, cameras and WiFi adapters.
2015-05-07 change footprint of usb host connector to one with pegs
    [red.kicad_pcb]
2015-05-07 gix usb host a footprint
    [red.kicad_pcb]
2015-06-16 image: Make the script more robust
    1. Handle exit calls so that proper cleanup is done in case of exit or any error
    2. Mount and unmount essential filesystems more cleanly
2015-06-16 image: Mount sysfs properly
2015-07-14 image: Fix mount and unmount order and way
2015-07-19 image: Patch for sakis3g to try to register to network after PIN verification
2015-08-07 image: Switch Mini-USB port from OTG to device
    With OTG and ID detection enabled a process called usb-hardware-sc is
    constantly in I/O wait state which results in a load constantly bigger
    than 1. This is not a real problem, as that process is not using the CPU.
    Linux just includes processes in uninterruptable sleep state into the
    load as well.
    Also the RED Brick hardware does not support host mode on the Mini-USB
    port anyway.
2015-08-07 image: Enable more HID kernel drivers
2015-08-13 image: sakis3g with 10 retries instead of 20 in case network registration problem. This will reduce delay if there is a problem registering with the network.
2015-10-14 image: Enable more Bluetooth kernel drivers
2015-11-03 image: Install sunxi mail driver into the correct directory
    Before, the Debian EGL/GLES packages shadowed the sunxi mali driver.
    Rebuild the Debian EGL/GLES packages with symlinks to libMail.so instead
    of the MESA drivers.
2016-02-03 put HDMI mounting pads in paste files
    [red.kicad_pcb]
2016-06-29 rtc-time: Remove debug print
2017-04-01 image: Update kernel device tree source and configuration
2017-04-04 image: Update device tree and kernel config
2017-04-07 image: Update device tree
2017-06-09 image: Update RED Brick device tree source
2017-06-13 image: Update device tree source
2017-06-28 image: Make rtl871xdrv driver default in hostapd for backward compatibility with older versions of Brick Viewer
2017-07-07 Add 3d information (tbc)
    [red.kicad_pcb]
2017-07-07 Fix symbols of 3,3V net
    [DDR.sch, HDMI_USB.sch, Processor.sch, Stack.sch, red.sch]
2017-07-07 Add 3d information capacitors and resistors (tbc)
    [DDR.sch, HDMI_USB.sch, Processor.sch, Stack.sch, red.sch]
2017-07-27 Add 3d information (final)
    [red.kicad_pcb]
2017-10-09 Basic changes for user-space switch from Debian Jessie to Stretch
2017-10-09 image: Build RTL8188EU driver from Git
2017-10-09 image: Install recompiled version of fbturbo driver and disable apt-daily
2017-10-09 image: While starting X and desktop environment first switch to tty2
2017-10-09 image: Add recompiled version of fbturbo driver
2017-10-09 image: Add package for installing the fbturbo driver
2017-10-09 image: Several fixes
    1. Move addition of tf user at the beginning of the process.
    2. Decouple lightdm removal from display driver installation.
    3. Add reboot and shutdown buttons on the panel.
2017-10-09 image: Update touch calibrator icon
2017-10-09 image: Add resources for adding reboot and restart panel buttons
2017-10-09 image: Add fbturbo driver and remove previous mali 3D stuff
2017-10-09 image: Fix icons for on panel reboot and shutdown buttons
2017-10-09 image: Install OpenHAB2 stable version and add preconfigured config files
    [addons.cfg, tinkerforge.cfg]
2018-02-20 Cleanup KiCad libraries config
    Ensure LibDir=kicad-libraries and LibName1=tinkerforge.
    Remove special library.
2018-02-27 image: Update kernel config and device tree
2018-07-20 image: Disable drm_kms_helper polling to solve system stalls every 10 seconds
2018-07-25 Add new 3d model
    [red.kicad_pcb]
2018-10-30 image: Additional loop block device support along with loop block device support
2019-03-29 Port binding tests to industrial dual relay bricklet.
    Also add C# test.
2019-11-15 image: Add RTL8821CU driver
2019-12-02 image: Add RTL8821CU Bluetooth driver support
2020-03-11 python: Report errors as exceptions to capture stack trace
2022-04-19 tests: Automatically end relay test
