Tinkerforge/red-brick/(notices)

Notices in the files:
hardware/red.kicad_pcb:
Copyright Tinkerforge GmbH 2014.
This documentation describes Open Hardware and is licensed under the
CERN OHL v. 1.1.
hardware/red.sch:
Copyright (©) 2017, B.Nordmeyer
